Tianyi-Lin/esp32_s3_scd41_co2_detector/3d_models/README.md

# 3D 模型与 FreeCAD 工程

此目录是本地 `ESP32-S3-LCD-1.47B_20260204 (1)` 模型文件夹在 2026-10-28 的快照，保留原有文件名和子目录。未收录 macOS `.DS_Store` 和 FreeCAD 自动备份；原始本地文件没有移动或删除。

## 先选版本，再编辑或打印

这里同时保存了多个设计阶段，**不是一套已经定稿、可以直接全部混用的打印包**。

当前优先查看：[盖板2.5mm_中壳加深_20261028](盖板2.5mm_中壳加深_20261028/)。前后盖基础板厚均为2.5mm，后盖无加深围边，新增深度由中间外壳承担；实际插头和导线空间仍待实物确认。

本版按钮最新突出 **1.5 mm**，侧脚钉高 **2 mm**，横放离桌间隙为 **0.5 mm**。请使用上述版本目录内的新按钮打印文件（打印2件），不要沿用根目录的旧1mm按钮。

四角外壳孔最新沿45°各向外平移 **0.3 mm**，柱体和斜切面随动；外轮廓和R4不变。**三件外壳孔位均已更新，前后盖和中间件必须配套使用，不要混装旧孔位版本。**

后盖中央传感器窗口最新约 **8.422×8.422 mm**，按穿过后盖的实际壳体外形每边留 **0.3 mm**；白色膜仍内缩约1mm。本次收小窗口只需更新后盖，四角孔位保持上述外移0.3mm版本。

| 位置 | 用途与状态 |
| --- | --- |
| `盖板2.5mm_中壳加深_20261028/` | 最新候选版，优先使用其中配套的独立工程、装配、STEP/STL；不要与历史版本混用。 |
| `草图直接编辑工程_修正版/` | 上盖、中间外壳和原下盖的草图/特征工程；优先从这里编辑上盖和中间外壳。 |
| `scripts/` | 本地模型生成、草图重建、历史修补、检查与导出的 Python 源码及 FreeCAD 宏；入口和运行风险见该目录的 README。 |
| `后盖_传感器横置_20261028/` | 传感器未倒装的横置后盖：模块长边平行外壳长边，安装孔距 X=20 mm、Y=18 mm。含独立可编辑后盖、STEP、STL 和装配检查。 |
| `后盖_传感器倒装_内缩1mm_20261028_预览/` | 已被新候选版取代的旧加深后盖方案，仅保留历史记录；不要作为当前方案。 |
| `打印文件/` | 此前导出的打印件与 STEP 快照；不自动包含后面两种后盖方案，使用前需核对版本。按键顶杆文件标注打印 2 件。 |
| `可编辑工程_参数化/`、`草图直接编辑工程/` | 更早阶段的工程及检查记录，作为历史参考；不要与修正版混淆。 |
| 根目录的装配、爆炸图和五色半透明检查工程 | 主要用于检查整机位置和装配关系，不替代各零件的完整草图特征工程。 |
| 根目录的 ESP32、Sensirion STEP/STP、PDF、DWG | 建模时使用的器件参考资料；原始第三方资料的权利与使用条款仍归其提供方。 |

## 旧加深后盖预览的历史说明

- SCD41 本体朝后盖外侧，传感器表面比后盖外表面内缩约 1 mm。
- 保持 ESP32 PCB 下表面到 CO₂ PCB 上表面约 20 mm；为此后盖外轮廓向外加深了 4.28 mm。前盖仍为 3 mm，后盖底板为 2 mm，整机总厚度约 36.53 mm。
- 用户已反馈整机前后显得过厚，需进一步评估布局和减薄方案。
- 模块两侧的接线插座目前仅以简化外形表示，**尚未计入实际插头、拔插操作和导线弯曲空间**。已有实体碰撞检查通过，不代表接线可装配性已验证。

## 如何手工编辑

使用 FreeCAD RC 打开对应零件的 `.FCStd` 文件，展开 `Body`，双击需要修改的 `Sketch` 或特征。各目录里的 `怎么编辑.txt`、`使用说明.txt` 和检查记录提供进一步说明。

- `.FCStd`：FreeCAD 工程；带草图/特征历史的独立零件适合手工改尺寸、孔位和特征。
- `.step` / `.stp`：交换实体几何，不能保留原始 FreeCAD 草图特征历史。
- `.stl`：打印用三角网格，不适合按原特征直接编辑。

模型相关 Python 源码和 FreeCAD 宏现已同步到 `scripts/`，保留本地源码内容，未因上传重新生成或修改模型几何。尺寸单位均为 mm，打印前请结合实际电路板、插头和紧固件再次核对。
