Tianyi-Lin/esp32_s3_scd41_co2_detector/3d_models/scripts/README.md

# 模型生成与检查源码

这里归档了本地建模工作区中与 ESP32-S3 / SCD41 外壳相关的 Python 脚本及 FreeCAD 宏。生成脚本、辅助模块、历史修补和检查脚本保留原文件名和代码；无关的毕业实验绘图、网络测试绘图脚本没有收录。

## 主要入口

| 文件 | 用途 |
| --- | --- |
| `redesign_uniform_covers.py` | 当前候选版入口：前后平板均2.5mm、后盖无外围围边，中间壳承担新增高度，维持1mm内缩与20mm板间距；导出独立工程、装配及经过验证的STEP/STL。 |
| `style_uniform_assembly.py` | 给当前候选版的无 GUI 信息装配添加外观：三件外壳50%半透明、电子器件不透明；校验原文档和几何数据逐字节不变。标准 Python 3 可运行。 |
| `fix_co2_connector_layout.py` | 将当前 CO₂ PCB 的两个简化插座改到长边方向左右两端；不旋转 PCB、不改变孔位和打印件；保留原装配显示外观并检查碰撞，输出到独立暂存目录。 |
| `apply_button_projection15.py` | 当前按钮突出1.5mm、脚钉2mm修正；保留内侧接触和限位，重导出中间件工程/STEP/STL和按钮STEP/STL（打印2件），验证0.5mm离桌间隙和0.8mm导向行程。 |
| `shift_corner_mounts.py` | 四角孔沿45°各外移0.3mm，三件孔位/沉孔及中间件柱体和八段斜切面同步；外形45.4×33.9/R4不变，保留按钮、脚钉和电子件，导出配套工程与STEP/STL。 |
| `resize_sensor_window.py` | 后盖中央窗口按真实SCD41在后盖内表面处的壳体截面每边+0.3mm，约8.422×8.422/R1.704；不按10.1mm远端凸缘放大，保持可编辑草图及1mm内缩，并检查实体间隙和STEP/STL。 |
| `design_inverted_scd41_cover.py` | 最新倒装后盖预览：传感器朝外、表面内缩约 1 mm，导出独立后盖及倒装装配。方案尚未定稿。 |
| `redesign_bottom_sensor_landscape.py` | 未倒装的横置后盖：长边平行外壳长边，安装孔距 X20 / Y18。 |
| `create_compact_stacked_enclosure.py` | 紧凑双层外壳的整机生成入口，调用本目录多个几何辅助模块。 |
| `rebuild_editable_enclosure.py` | 将实体重建成参数化零件。 |
| `rebuild_direct_sketch_enclosure.py` | 生成带草图和特征历史的独立编辑工程；依赖上一个模块。 |
| `repair_sketch_engineering.py`、`repair_top_native_fillet.py` | 草图孔位联动修正及上盖圆角修复。 |
| `create_exploded_inspection.py` | 爆炸检查工程。 |
| `create_five_color_inspection.FCMacro` | 五色半透明装配检查宏，需要 FreeCAD 图形界面。 |
| `export_checked_enclosure_steps.py`、`audit_print_mesh_orientation.py` | STEP 导出和打印网格检查。 |

其余 `apply_*`、`resize_*`、`update_*` 等包含历史阶段的几何修改；`inspect_*`、`audit_*`、`test_*`、`probe_*` 等记录检查或试验。文件名前缀不保证只读，应先看代码中的保存、导出语句。

## 运行前必读

1. 这些是**原始工作源码快照**，不是一个可直接“一键顺序运行所有文件”的发布工具包。上传时只验证了语法和源码同步，没有重新执行建模，也没有重新验证所有历史脚本。
2. 许多脚本保留原机器的绝对路径，包括模型目录、`sys.path` 和 `.cad-recovery` 输出目录。在其他位置运行前，必须核对并修改对应路径；不要只修改一个入口却忽略其导入模块。
   当前 `redesign_uniform_covers.py` 及其两个草图生成直接依赖已支持同目录导入、仓库相对路径；入口可传 `--root` 指定模型目录，输出到该目录下独立的 `.cad-recovery` 暂存文件夹。此改进不代表其他历史脚本已全部迁移。
3. 部分脚本在导入或执行时会创建工程、修改已有文件或保存导出。**先复制模型到独立测试目录，再运行**；不要直接针对唯一的模型原件执行，也不要把历史修补脚本重复应用到最新零件。
4. 几何脚本依赖 FreeCAD 自带 Python 模块，如 `FreeCAD`、`Part`、`Sketcher`、`Mesh`、`MeshPart`；普通系统 Python 通常不能直接运行。带 `FreeCADGui` 的脚本需要图形界面。部分检查还依赖 NumPy 等模块。
5. 本次建模使用 FreeCAD 26.3.0 RC2。主生成脚本不代表所有历史脚本都经过此版本的独立回归测试。
6. 最新倒装预览依赖横置装配以及草图重建辅助模块；生成后仍需解决整机厚度和实际接线插头空间问题，不能据此直接认定可打印装配。

脚本与已保存模型共同归档，但并非每个历史脚本都对应当前发布的几何状态。已有 `.FCStd` 才是本次同步的模型快照；手工改尺寸时可直接使用带草图特征的工程。
