Tianyi-Lin/esp32_s3_scd41_co2_detector/3d_models/盖板2.5mm_中壳加深_20261028/README.md

# 当前候选版：前后盖 2.5 mm，新增深度由中间外壳承担

这是 2026-10-28 按最新要求修改的独立版本，原来的横置后盖和加深后盖预览均保留，不覆盖历史工程。

## 本次修改

- 前盖基础板厚 **2.5 mm**，后盖基础板厚 **2.5 mm**。
- **后盖没有外围加深围边**，外底面 Z=0，内侧大平面 Z=2.5；内部四个传感器安装支撑台保留。这些局部支撑台不属于板厚或外围围边。
- SCD41 保持长边平行外壳长边，安装孔距 X20 / Y18；传感器倒装朝外，表面低于后盖外表面约 **1 mm**。
- 后盖中央传感器窗口已从 10.7×10.7 mm 收小到约 **8.422×8.422 mm、R1.704**。依据真实 STEP 在后盖内表面 **Z=2.5 mm** 处约 7.822×7.822 mm 的壳体外形，每边留 **0.3 mm**；不再把远离后盖的 10.1 mm PCB 侧凸缘作为窗口尺寸。稍椭圆的角部用可编辑圆弧草图拟合，截面间隙偏差在 0.002 mm 内。
- CO₂ PCB 安装面 Z=7.28，PCB 上表面 Z=8.48；ESP32 PCB 下表面 Z=28.48，两块 PCB 的垂直距离保持 **20 mm**。
- 新增高度由中间外壳承担；中层板、ESP32、Type-C 窗口和按钮同步上移 **4.28 mm**。侧脚钉、双层四角螺丝柱的 45°平面切削等结构保留。
- 两侧按钮由突出 1 mm 改为 **1.5 mm**；R1.5 半球端头的赤道与壳面齐平，内侧接触面、限位环及 0.8 mm 导向行程保持不变。经确认，四个一体脚钉由 1.5 mm 加高至 **2 mm**，横放时按钮离桌面仍为 **0.5 mm**，脚端 R0.35 圆角不变。
- 相比横置、未倒装版本，中间件下配合面从 Z2.05 改为 Z2.55，上配合面上移 4.28 mm，所以中间件零件高度净增加 **3.78 mm**，变为约 **30.98 mm**。
- 前后盖四角通孔同轴，M2.5 沉孔直径仍为 **5.1 mm**。前盖沉孔深 1.35，后盖沉孔深 1.4。
- 四角外壳固定孔现各沿 **45° 向外平移 0.3 mm**，即 X/Y 各移约 0.212132 mm；孔轴心为 **X=±19.072132、Y=±13.032132 mm**。中间件的螺丝柱及上下两层共八段 45° 切削面同步平移，切面距孔轴心仍为 2.781853 mm，按 M2.5 公称直径计算切面侧最薄壁仍约 1.531853 mm。
  三件外轮廓 **45.4×33.9、R4** 不变，Ø5.1 沉孔到外缘最薄约 **1.068912 mm**。ESP32/CO₂ 自身固定孔、屏幕、接线插座、按钮和脚钉位置不变。
- 减薄后重建了显示窗的上口过渡：下口仍为 **32.85×17.89、R2.5、中心 X=-1.5675**；上口改为同心等宽外扩的 **35.946×20.986、R4.048**，保留 R0.4 上缘过渡。没有改变显示区域的下口位置。此调整消除了旧偏心斜面在 STEP 转换和网格化时的问题。

整机前后外表面距离约 **36.03 mm**。本次主要统一盖板并转移加深结构，不代表已压缩 20 mm 接线空间。

## 文件

- `装配检查_盖板2.5mm_中间壳加深.FCStd`：完整紧凑装配，包含两块电路板、SCD41 本体及两个简化插座。
  前盖（蓝）、后盖（紫）、中间壳（橙）均为 **50% 半透明**；ESP32（绿）和 CO₂ 模块（红）保持不透明。此项仅为显示外观，尺寸、装配位置、独立零件工程和打印文件未改变。
  CO₂ PCB 的两个接线插座已从上下边修正到**左右两端（沿 PCB 长边 X）**，不是旋转整块电路板；PCB、固定孔、传感器本体及打印件均保持原位。插座仍是沿用原尺寸的简化占位体，插头和导线未建模。
- `上盖_2.5mm_草图编辑.FCStd`、`后盖_2.5mm_无围边_草图编辑.FCStd`、`中间外壳_加深_草图编辑.FCStd`：独立草图/特征工程。
- `打印文件/`：对应本版的三件外壳及按钮的 STL、STEP。按钮文件为 `按键顶杆_突出1.5mm_打印2件`，同一模型打印 **2 件**，已按限位环平底朝下、半球朝上放置。不要混用旧目录中的 1 mm 按钮、后盖或中间件。
- `检查记录.json`：实体、STEP 读回、STL、孔位同轴及装配碰撞检查结果。
- 生成源码：`../scripts/redesign_uniform_covers.py`。在 FreeCAD Python 环境执行，默认使用所在仓库的模型目录，也支持 `--root`；输出到独立暂存目录，不覆盖输入工程。
- 半透明外观保存工具：`../scripts/style_uniform_assembly.py`。用于给没有 GUI 显示信息的新生成装配添加上述外观；已有显示信息时会拒绝覆盖。
- 接线插座布局修正：`../scripts/fix_co2_connector_layout.py`，检查记录为 `接线插座布局检查.json`；主生成入口也会应用此修正。
- 按钮与脚钉修正：`../scripts/apply_button_projection15.py`，记录为 `按钮1.5mm_脚钉2mm检查.json`。独立中间件工程的 `FootPad.Length` 现为 2 mm；装配、打印中间件与按钮导出均已同步。
- 四角孔位修正：`../scripts/shift_corner_mounts.py`，记录为 `四角孔外移0.3mm检查.json`。**前盖、后盖、中间件的孔位都变了，必须使用本目录最新的配套三件，不能与外移前版本混装。** 各单项检查记录保留变更当时的状态，最新汇总以 `检查记录.json` 为准。
- 传感器窗口修正：`../scripts/resize_sensor_window.py`，记录为 `传感器窗口每边0.3mm检查.json`。这次仅更新后盖及装配中的后盖，不改变四角孔位；此前已按四角外移0.3mm版本打印的前盖、中间件和按钮可以继续使用。

## 检查边界

三件外壳均为单一有效实体，独立工程保存后可重开、草图完全约束；STEP 读回通过扩展几何检查。外壳和按钮 STL 均封闭、单连通，无非流形、无自交、无不一致三角面朝向。两侧按钮镜像后为相同打印件，内侧接触面未改变，0.3/0.5/0.8 mm 按压位移检查无外壳碰撞。现有装配模型检查的部件之间无体积重叠。

**实际插头、拔插操作和导线弯曲空间仍未验证。** 两个插座仍是简化外形，现有模型无碰撞不等于实物接线已确认。本版是用于继续检查的候选版，打印前仍需结合插上线的传感器实物核对。
