Tianyi-Lin/esp32_s3_scd41_co2_detector/3d_models/可编辑工程_参数化/使用说明.txt

三个独立的 FreeCAD 参数化工程
============================

打开方式
使用 FreeCAD 26.3 RC2 打开：
  上盖_参数化.FCStd
  下盖_参数化.FCStd
  中间外壳_参数化.FCStd

这不是 STEP 改后缀，也不是在导入实体上附加空草图。
三件均由原生草图、尺寸约束、拉伸、凹槽、放样和圆角特征重建。
文件不依赖生成脚本、自定义 Python 模块或外部模型链接。

怎样修改尺寸
1. 展开左侧文件名称，双击“尺寸参数（双击，修改 B 列）”。
2. A 列是参数名称，B 列是尺寸，C 列是说明。
3. 修改 B 列黄色单元格，例如孔径改为“2.3 mm”，按回车。
4. 灰色单元格是公式计算值，通常不直接改。
5. 如未刷新，选择“编辑 → 重新计算”（Command+R）。
6. 保存前查看模型是否出现红色错误标记，并检查孔位、壁厚及装配。

负数位置请输入公式格式，例如“=-16.814 mm”。
不要把尺寸写成纯文字或删除单位。

怎样修改草图、建模特征
展开“可编辑实体”中的特征即可找到对应草图。
双击草图可以进入编辑；尺寸约束已与尺寸表连接，日常改尺寸优先改表。
如要将某个草图尺寸改为独立数值，需要先移除该尺寸原来的表达式引用。
也可以继续在 Body 内增加新的草图、拉伸、凹槽等特征。
保持最终特征可见，不要同时显示全部历史特征。

各文件内容
上盖：外轮廓、厚度、显示窗上下截面、斜面、外口圆角、四角通孔、沉孔。
下盖：外轮廓、厚度、CO2 凸台、18×20 mm 孔距、通孔、沉孔、37 个透气孔。
中间外壳：侧壁、中层板、四角柱、ESP32 凸台与通孔、排针槽、中央开口、
45 度切削、Type-C 开口、按钮导向与滑动孔、两侧通风槽、四个脚钉及圆角。

独立文件之间的关系
三件保留了原装配坐标，不是把所有零件都移动到底面 Z=0。
三件没有相互的外部链接。改共同外轮廓、四角孔距或接合高度时，
需要同步修改其他相关文件，并重新检查装配。
这些文件不会自动改动旧装配图、STEP 或 STL。
修改后要打印，应选择 Body 的最终实体重新导出，不要误用旧打印文件。

验证与限制
下盖、中间外壳与现版原模型的实体差集均为零，外形一致。
上盖的孔、圆柱面与外包络一致；显示窗曲面双向采样对比的最大偏差
约 0.00072 mm，体积差约 0.0064 mm³，属于本次圆角重建的微小数值差。
上盖保留了原模型圆角曲面的 GeomAbs_C0 连续性诊断信息；
普通实体有效性检查通过，不将扩展检查描述为“全部无警告”。
上盖以线性偏差 0.001 mm、角度偏差 0.03 rad 试算网格：303718 个三角面，
单一封闭网格，无非流形边、无反向三角面、无自交；未覆盖原 STL。
30 张草图均完全约束。测试过尺寸、孔径、孔位、槽距、切削偏距等修改，
均能重新计算，测试后已恢复原值，三个文件均已保存并重新打开验证。
这些检查不代表任意大幅改动都不会失败，也不是打印强度或螺纹可靠性认证。
原装配工程及已有打印文件未覆盖。
