Tianyi-Lin/esp32_s3_scd41_co2_detector/3d_models/后盖_传感器倒装_内缩1mm_20261028_预览/设计说明.txt

SCD41 倒装、白色表面内缩 1 mm — 独立预览版

本版按现有真实 SCD41 本体 STEP 和 20×18 mm 安装孔距设计。
传感器保持横放，25.4 mm 长边平行外壳长边；PCB 翻面，传感器朝后盖外侧。
后盖中央开贯穿窗口，让传感器上表面直接面向外部空气。
白色表面比后盖外表面向内退让约 1 mm，壳体不顶压白色表面。

重要外形变化：
现有传感器本体从 PCB 元件面到白色表面高 6.28 mm。
为保持之前 ESP32 PCB 下表面至 CO2 PCB 上表面的 20 mm 空间，
本版让后盖向外加深 4.28 mm，采用浅盒形状，未移动中间壳、ESP32 或上盖。
新后盖与中间壳的配合平面、外侧四孔位置、45.4×33.9 mm 外轮廓保持。
整机厚度相应增加 4.28 mm；请先看装配预览，确认外凸量再用于下单。

主要尺寸：
后盖底板厚 2 mm，新增围边壁厚 2.2 mm。
传感器窗口 10.7×10.7 mm、R0.7，名义上相对本体10.1mm包络每侧让位0.3mm。
传感器支撑台从新底板内侧起高 5.28 mm、外径5 mm，顶面仍在原安装高度。
四个安装孔中心距沿外壳长边20 mm、沿短边18 mm；通孔Ø2.8 mm。
八个外侧平底沉孔均为Ø5.1 mm、深1.4 mm。
原中央通气孔区域改成传感器窗口，窗口外围保留12个Ø1.5 mm圆孔。

文件：
装配检查_传感器倒装_薄膜内缩1mm.FCStd：完整装配的独立预览。
后盖_传感器倒装_薄膜内缩1mm_预览.FCStd：带草图/特征历史的可编辑后盖。
后盖_传感器倒装_薄膜内缩1mm_预览.step：用于检查几何或给打印方。
后盖_传感器倒装_薄膜内缩1mm_预览.stl：仅后盖的打印网格。
检查记录.json：本轮尺寸、碰撞和网格检查结果。

查看建议：
打开完整装配后，切换到底视图看外侧窗口与白色表面。
打开后盖 STEP，可单独看中央窗口、四个长支撑台和新增围边。
FreeCAD RC 此前有过打开/切换 FCStd 时退出的情况，查看几何时可先用 STEP。

手工编辑：
可编辑工程中的“倒装保护尺寸”保存薄膜退让量、传感器高度和安装基准。
默认 MembraneRecess=1 mm；修改后后盖底板、围边和支撑高度会联动。
修改“CO2 横置孔位草图（主控：20×18）”，对应通孔和沉孔保持同轴。
外侧四孔有独立主控草图；其他独立零件文件不会跨文件自动同步。

检查结果：
原生后盖、重新读入的 STEP 均为单一有效实体，扩展几何检查通过。
保存后重新打开的草图均为完全约束状态，装配中的退让尺寸检查通过。
STL 重新读入后为单壳体、封闭、无非流形边、无自交且面方向一致。
倒装的 PCB、SCD41 本体和插座逐件检查，与后盖、侧壁、中层、ESP32、
排针预留体及上盖的实体重叠均为零。
ESP32 PCB 下表面至 CO2 PCB 上表面仍为20 mm。

装配前需与实物核对：
本模型未包含实际线缆与插头的全部形状；请核对实物PCB元件面及接线空间。
1 mm 退让用于减少表面擦碰，窗口没有增加护网，不能完全隔绝手指或尖物。
加深后需要重新核对螺丝长度；若保持与原来相同的螺纹啮合长度，
穿过后盖的螺杆应相应增加约4.28 mm。

旧装配、上一版横置后盖和原“打印文件”均未覆盖。
