Tianyi-Lin/esp32_s3_scd41_co2_detector/3d_models/后盖_传感器横置_20261028/使用说明.txt

2026-10-28 后盖：SCD41 传感器横置修正版

核对结果：旧模型的传感器 PCB 长边沿外壳短边，方向相差 90°。
本版将传感器长边改为平行外壳长边，并同步调整后盖四个支撑台、
四个通孔及对应沉孔。孔距沿外壳长边 20 mm，沿短边 18 mm，均为中心距。
孔中心坐标：X=±10 mm，Y=±9 mm。

打印：后盖_传感器横置_20x18mm.stl
也可向打印方提供：后盖_传感器横置_20x18mm.step
可编辑工程：后盖_传感器横置_20x18mm.FCStd，使用 FreeCAD RC 打开。
装配核对：装配检查_传感器横置.FCStd，已把传感器和后盖一起改为横置。
装配文件用于检查；只需打印后盖，不要把传感器或整套装配一起打印。

后盖外形仍为 45.4×33.9 mm，基板厚 2 mm，支撑台高 1 mm。
外侧四个外壳固定孔的位置保持不变，可继续使用现有中间壳和上盖。
传感器安装支撑台外径 5 mm，通孔直径 2.8 mm；外侧平底沉孔
直径 5.1 mm、深 1.4 mm，保持之前尺寸。
原来的 37 个底部通气孔保持不变，距新沉孔的最小净距为 1.7 mm。

当前装配模型中的传感器 PCB 外形为 25.4×22.86 mm，安装高度不变。
横置后与侧壁最小间隙约 3.32 mm，与 ESP32、排针预留体无实体重叠。
模型孔位依据此前确认的长边 20 mm、短边 18 mm；打印前可再与实物
四个孔的中心距核对。

可编辑工程中，修改“CO2 横置安装孔位草图（主控：长边20、短边18）”
的 HoleN_X / HoleN_Y，对应通孔和沉孔会自动跟随；孔径单独控制。
此文件与旧装配和其他独立工程没有跨文件自动同步。

已检查原生实体与重新读入的 STEP：单一有效实体，扩展几何检查通过。
STL 已重新读入检查：封闭、单壳体、无非流形边、无自交，面方向一致。
保存后重新打开的孔位检查通过，详细结果见“检查记录.json”。
旧版装配、工程及“打印文件”文件夹均未覆盖。需要新后盖时使用本文件夹。
