Tianyi-Lin/esp32_s3_scd41_co2_detector/3d_models/ESP32-S3-LCD-1.47B_紧凑装配_五色半透明检查.FCStd

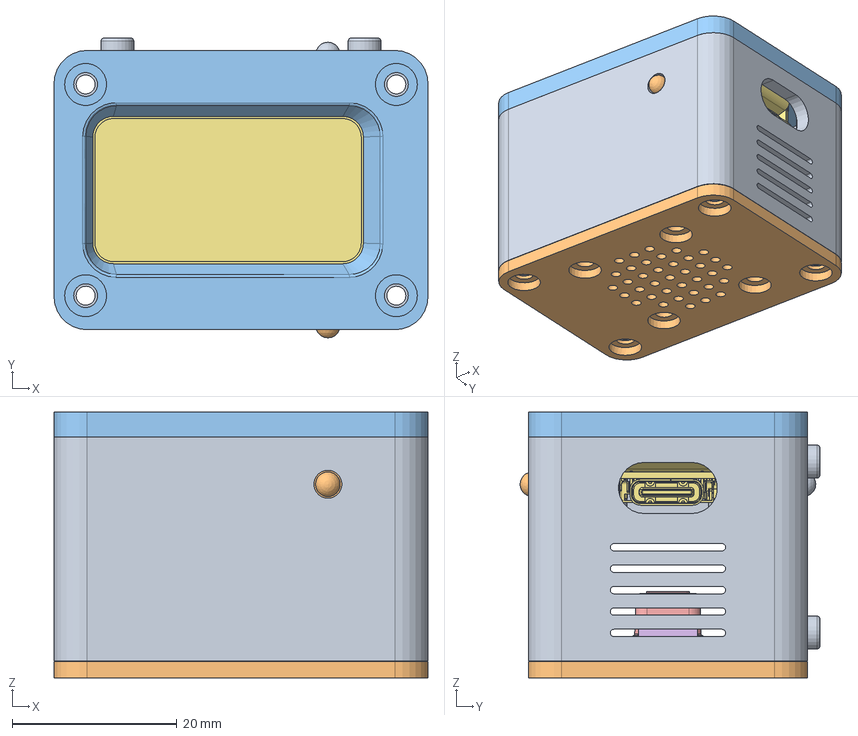
[picture p1: CAD file, 2026-10-28]
3d_models/ESP32-S3-LCD-1.47B_紧凑装配_五色半透明检查.FCStd
45.4 x 36.4 x 32.3 mm
03 中间外壳｜橙色
02 下盖｜紫色
前盖（内侧同平面，无微小环形台阶）
05 CO2 模块 PCB｜红色
CO2 SCD41 传感器本体｜红色
CO2 模块插座｜红色
04 ESP32 总成｜绿色
ESP32 排针参考｜绿色
中间外壳附属按钮 1｜橙色
中间外壳附属按钮 2｜橙色
