Tianyi-Lin/esp32_s3_scd41_co2_detector/3d_models/可编辑工程_参数化/下盖_参数化.FCStd

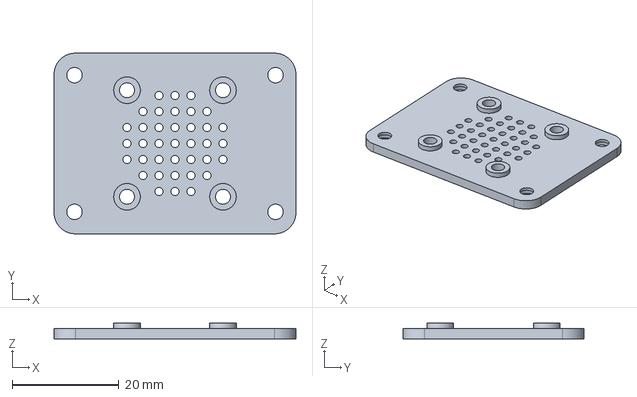
[picture p2: CAD file, 2026-10-28]
3d_models/可编辑工程_参数化/下盖_参数化.FCStd
45.4 x 33.9 x 3.00 mm
