Tianyi-Lin/esp32_s3_scd41_co2_detector/3d_models/后盖_传感器倒装_内缩1mm_20261028_预览/后盖_传感器倒装_薄膜内缩1mm_预览.step

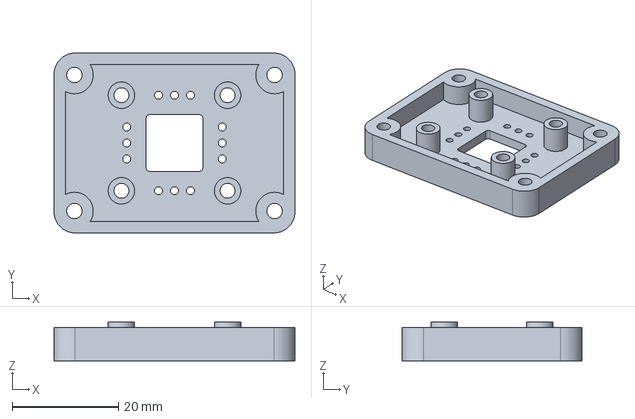
[picture p3: CAD file, 2026-10-28]
3d_models/后盖_传感器倒装_内缩1mm_20261028_预览/后盖_传感器倒装_薄膜内缩1mm_预览.step
45.4 x 33.9 x 7.28 mm
