Tianyi-Lin/esp32_s3_scd41_co2_detector/3d_models/打印文件/ESP32-S3-LCD-1.47B_紧凑双层外壳_后壳.stl

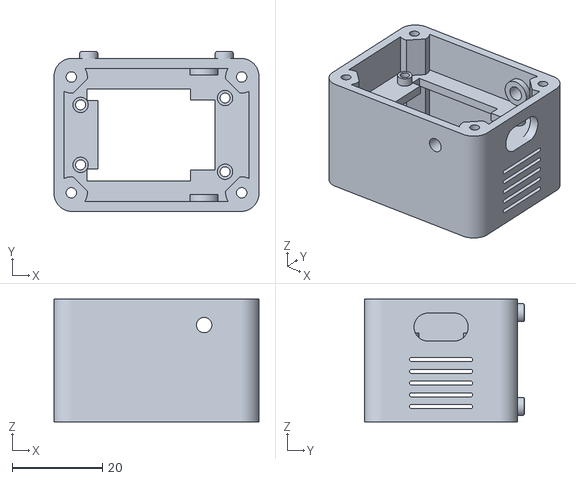
[picture p4: CAD file, 2026-10-28]
3d_models/打印文件/ESP32-S3-LCD-1.47B_紧凑双层外壳_后壳.stl
45.4 x 35.4 x 27.2
