Tianyi-Lin/esp32_s3_scd41_co2_detector/3d_models/打印文件/STEP/ESP32-S3-LCD-1.47B_上盖.step

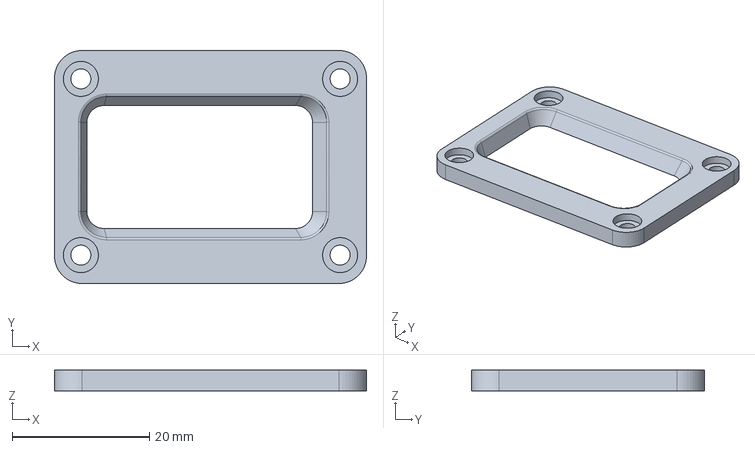
[picture p5: CAD file, 2026-10-28]
3d_models/打印文件/STEP/ESP32-S3-LCD-1.47B_上盖.step
45.4 x 33.9 x 3.00 mm
