Tianyi-Lin/esp32_s3_scd41_co2_detector/3d_models/盖板2.5mm_中壳加深_20261028/打印文件/后盖_2.5mm_无围边_草图编辑.step

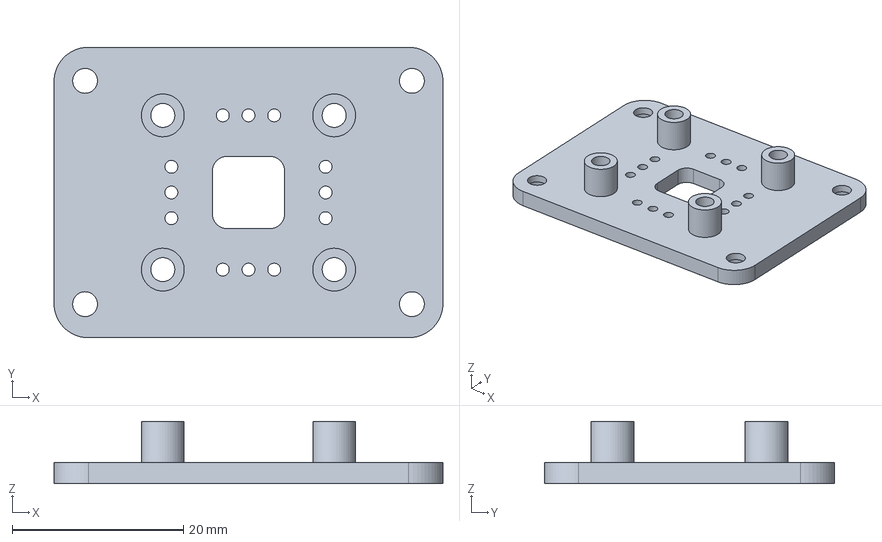
[picture p6: CAD file, 2026-10-28]
3d_models/盖板2.5mm_中壳加深_20261028/打印文件/后盖_2.5mm_无围边_草图编辑.step
45.4 x 33.9 x 7.28 mm
