Tianyi-Lin/esp32_s3_scd41_co2_detector/3d_models/盖板2.5mm_中壳加深_20261028/装配检查_盖板2.5mm_中间壳加深.FCStd

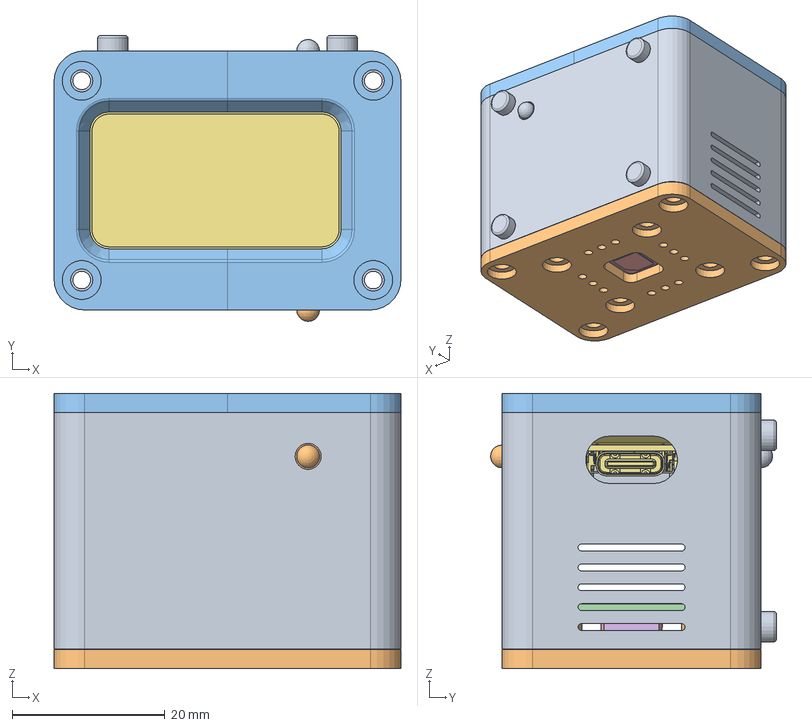
[picture p7: CAD file, 2026-10-28]
3d_models/盖板2.5mm_中壳加深_20261028/装配检查_盖板2.5mm_中间壳加深.FCStd
45.4 x 37.4 x 36.0 mm
中间外壳（承担新增高度）
后盖 平板2.5mm（无加深围边）
前盖 平板2.5mm
CO2 横置PCB（倒装安装面Z7.28）
SCD41 朝外（表面内缩1mm）
SCD41 左右接线插座（简化外形，沿长边X）
ESP32 总成（旋转 90°，前层）
焊接排针穿透预留（2×9，间距 2.54）
内装式单圆台推杆（BOOT/RST，打印件 1）
内装式单圆台推杆（BOOT/RST，翻转件 2）
