Tianyi-Lin/esp32_s3_scd41_co2_detector/3d_models/Sensirion_CO2_Sensors_SEK-SCD41_STEP_file.STEP

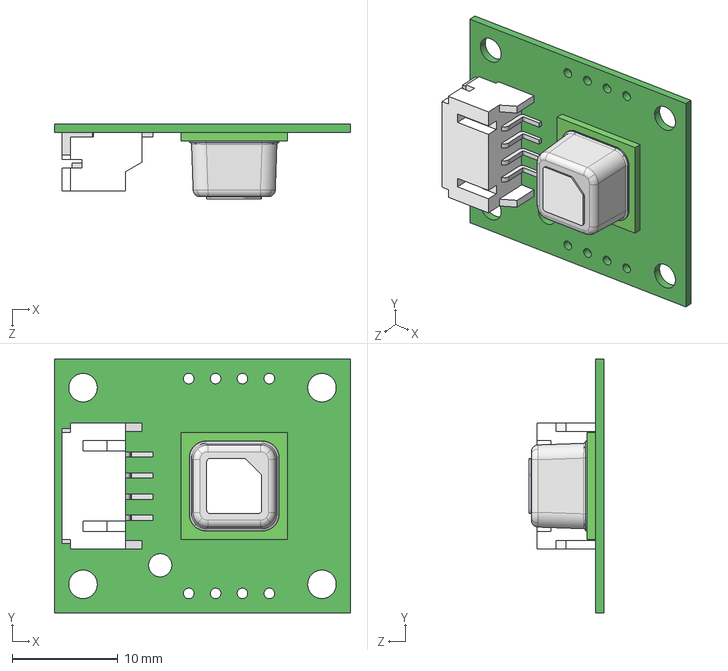
[picture p8: CAD file, 2026-10-28]
3d_models/Sensirion_CO2_Sensors_SEK-SCD41_STEP_file.STEP
28.0 x 24.0 x 7.11 mm
