Tianyi-Lin/esp32_s3_scd41_co2_detector/3d_models/后盖_传感器倒装_内缩1mm_20261028_预览/装配检查_传感器倒装_薄膜内缩1mm.FCStd

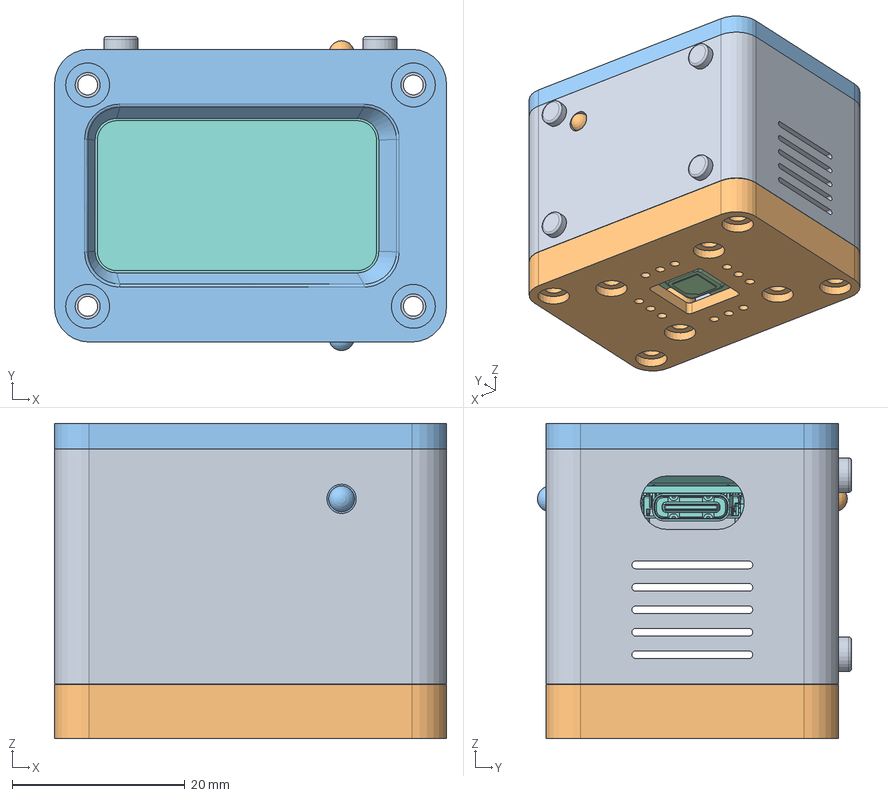
[picture p9: CAD file, 2026-10-28]
3d_models/后盖_传感器倒装_内缩1mm_20261028_预览/装配检查_传感器倒装_薄膜内缩1mm.FCStd
45.4 x 36.4 x 36.5 mm
侧壁＋中间层（上下盖 M2.5 攻丝柱）
倒装保护后盖（向外加深4.28mm，薄膜内缩1mm）
前盖（内侧同平面，无微小环形台阶）
SCD41 横置倒装总成（PCB高度保持）
SCD41 黑色 PCB（背面朝下）
SCD41 倒装朝外（薄膜低于后盖1mm）
SCD41 上下 STEMMA QT 插座
ESP32 总成（旋转 90°，前层）
焊接排针穿透预留（2×9，间距 2.54）
内装式单圆台推杆（BOOT/RST，打印件 1）
内装式单圆台推杆（BOOT/RST，翻转件 2）
