Tianyi-Lin/esp32_s3_scd41_co2_detector/3d_models/后盖_传感器横置_20261028/装配检查_传感器横置.FCStd

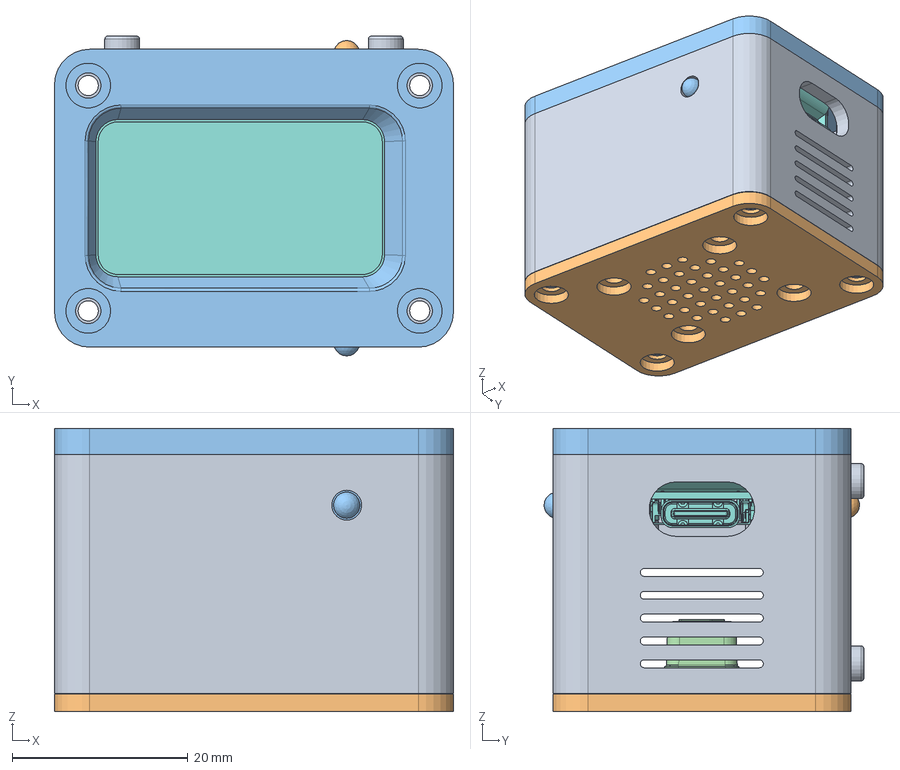
[picture p10: CAD file, 2026-10-28]
3d_models/后盖_传感器横置_20261028/装配检查_传感器横置.FCStd
45.4 x 36.4 x 32.3 mm
侧壁＋中间层（上下盖 M2.5 攻丝柱）
后盖：传感器横置，孔距长边20 mm/短边18 mm
前盖（内侧同平面，无微小环形台阶）
SCD41 横置总成（长边平行外壳长边）
SCD41 黑色 PCB（背面朝下）
SCD41 传感器本体（真实 STEP，朝上）
SCD41 上下 STEMMA QT 插座
ESP32 总成（旋转 90°，前层）
焊接排针穿透预留（2×9，间距 2.54）
内装式单圆台推杆（BOOT/RST，打印件 1）
内装式单圆台推杆（BOOT/RST，翻转件 2）
