Tianyi-Lin/esp32_s3_scd41_co2_detector/3d_models/ESP32-S3-LCD-1.47B.stp

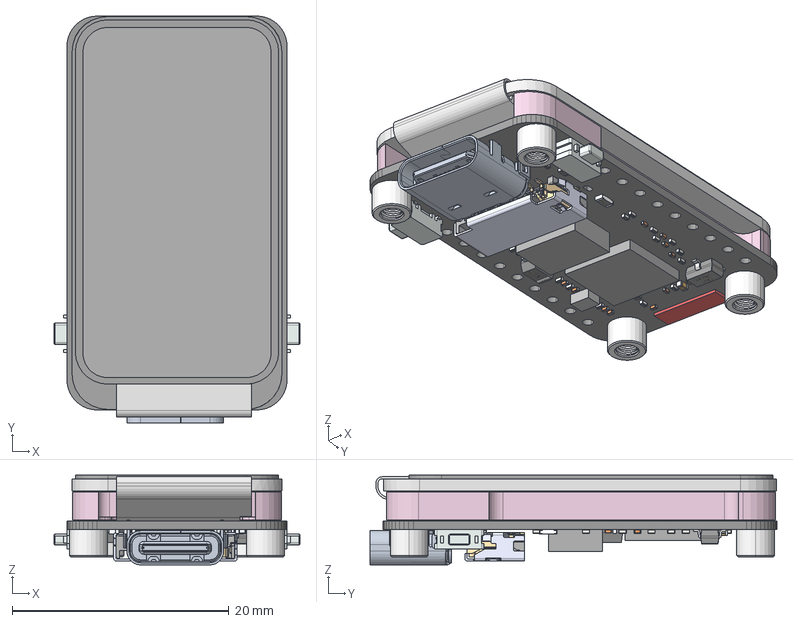
[picture p12: CAD file, 2026-10-28]
3d_models/ESP32-S3-LCD-1.47B.stp
22.7 x 37.6 x 8.30 mm
1_47INCH-172X320-LCD
BOARD
_2_1_2_3_4_AF0 x 2
_7_1_2_AF0 x 2
USER_LIBRARY-0201_0603M__CAP_1 x 20
USER_LIBRARY-0201_0603M__CAP_2 x 20
USER_LIBRARY-0201_0603M__CAP_3 x 20
EXTRUDED-66940
SOT23-5AND6_00 x 5
SOT23-5-14065_AF0
EXTRUDED-124313
EXTRUDED-124708
USER_LIBRARY-RES_0603-0201_1 x 31
USER_LIBRARY-RES_0603-0201_2 x 31
USER_LIBRARY-RES_0603-0201_3 x 31
USER_LIBRARY-RES_0603-0201_4 x 31
5_1_2_A
_7_AF0
SOT-23 x 2
EXTRUDED-184200
EXTRUDED-184623
EXTRUDED-185018
3_1_A x 4
3_1_2_A
SOD123F
PRT0001
ESP32-S3-LCD-1_47B-PMMA
SWITCH-TS24CA x 2
SMTSO-M2-2_5ET x 4
TF-CARD-BASE
