Tianyi-Lin/esp32_s3_scd41_co2_detector/3d_models/盖板2.5mm_中壳加深_20261028/上盖_2.5mm_草图编辑.FCStd

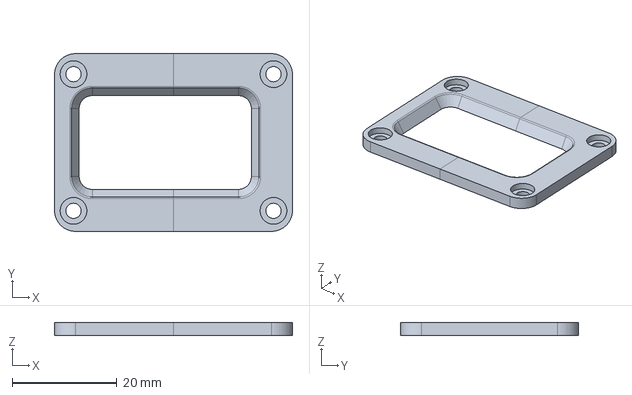
[picture p13: CAD file, 2026-10-28]
3d_models/盖板2.5mm_中壳加深_20261028/上盖_2.5mm_草图编辑.FCStd
45.4 x 33.9 x 2.50 mm
