Tianyi-Lin/esp32_s3_scd41_co2_detector/3d_models/ESP32-S3-LCD-1.47B_装配检查_爆炸图.FCStd

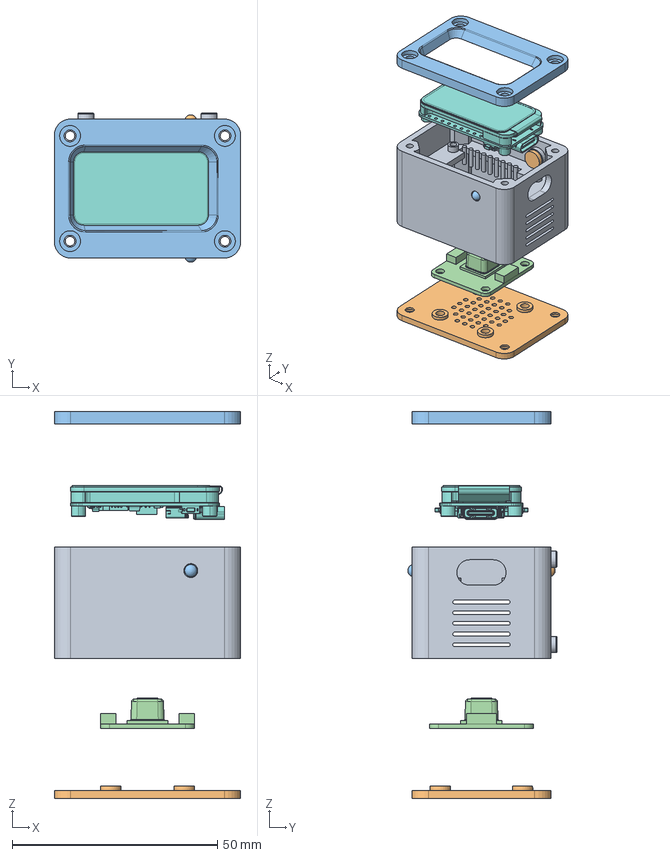
[picture p14: CAD file, 2026-10-28]
3d_models/ESP32-S3-LCD-1.47B_装配检查_爆炸图.FCStd
45.4 x 36.4 x 94.3 mm
侧壁＋中间层（上下盖 M2.5 攻丝柱）
可拆下盖（M2.5 螺丝固定到侧壁）
前盖（内侧同平面，无微小环形台阶）
SCD41 总成碰撞参考（含真实 STEP 本体）
SCD41 黑色 PCB（背面朝下）
SCD41 传感器本体（真实 STEP，朝上）
SCD41 上下 STEMMA QT 插座
ESP32 总成（旋转 90°，前层）
焊接排针穿透预留（2×9，间距 2.54）
内装式单圆台推杆（BOOT/RST，打印件 1）
内装式单圆台推杆（BOOT/RST，翻转件 2）
