Tianyi-Lin/esp32_s3_scd41_co2_detector/3d_models/盖板2.5mm_中壳加深_20261028/打印文件/按键顶杆_突出1.5mm_打印2件.step

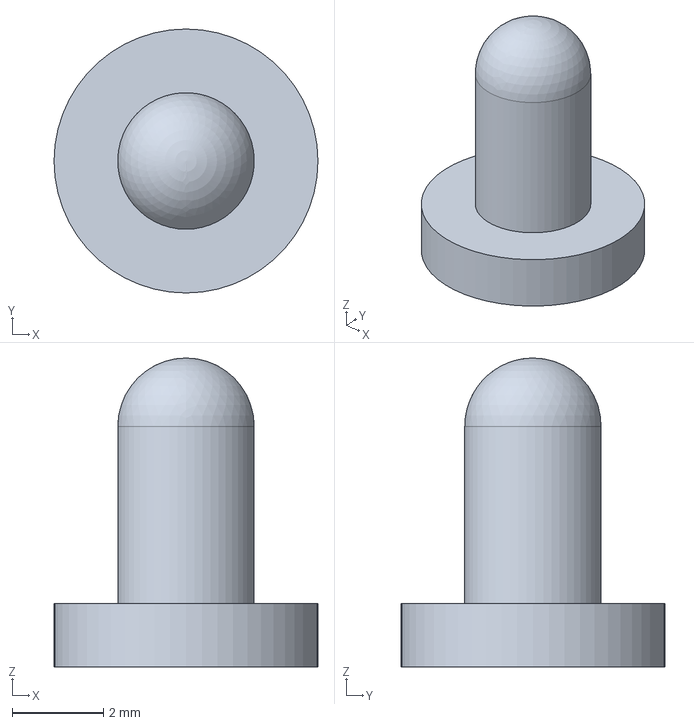
[picture p15: CAD file, 2026-10-28]
3d_models/盖板2.5mm_中壳加深_20261028/打印文件/按键顶杆_突出1.5mm_打印2件.step
5.80 x 5.80 x 6.79 mm
