Tianyi-Lin/esp32_s3_scd41_co2_detector/3d_models/ESP32-S3-LCD-1.47B_紧凑双层外壳_按键顶杆_打印2件.stl

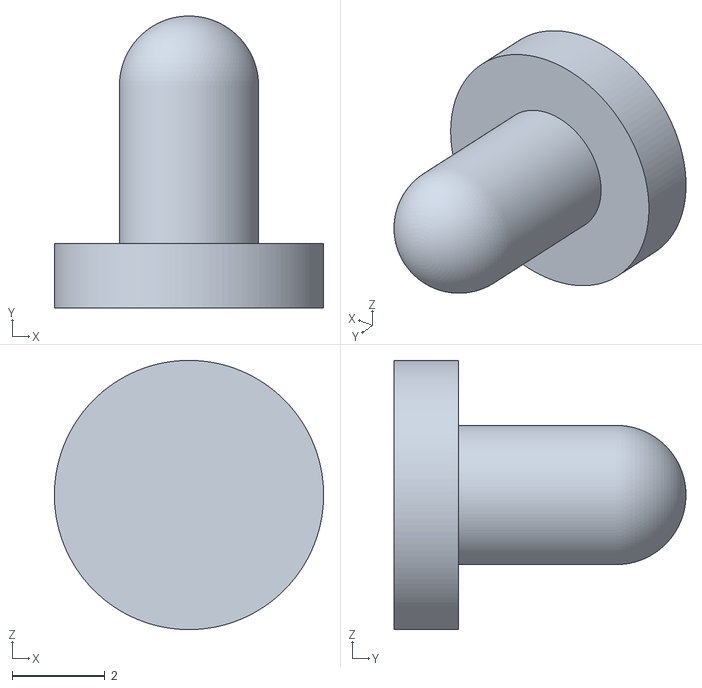
[picture p16: CAD file, 2026-10-28]
3d_models/ESP32-S3-LCD-1.47B_紧凑双层外壳_按键顶杆_打印2件.stl
5.80 x 6.29 x 5.80
