Tianyi-Lin/esp32_s3_scd41_co2_detector/(list of files, cad)

Other CAD files:
3d_models/后盖_传感器横置_20261028/后盖_传感器横置_20x18mm.step
3d_models/草图直接编辑工程/上盖_草图编辑.FCStd
3d_models/草图直接编辑工程_修正版/上盖_草图编辑.FCStd
3d_models/可编辑工程_参数化/中间外壳_参数化.FCStd
3d_models/打印文件/ESP32-S3-LCD-1.47B_紧凑双层外壳_可拆底盖.stl
3d_models/打印文件/STEP/ESP32-S3-LCD-1.47B_下盖.step
3d_models/盖板2.5mm_中壳加深_20261028/后盖_2.5mm_无围边_草图编辑.FCStd
3d_models/草图直接编辑工程/下盖_草图编辑.FCStd
3d_models/草图直接编辑工程_修正版/中间外壳_草图编辑.FCStd
3d_models/可编辑工程_参数化/上盖_参数化.FCStd
3d_models/打印文件/STEP/ESP32-S3-LCD-1.47B_中间件.step
3d_models/盖板2.5mm_中壳加深_20261028/打印文件/上盖_2.5mm_草图编辑.step
3d_models/草图直接编辑工程/中间外壳_草图编辑.FCStd
3d_models/草图直接编辑工程_修正版/下盖_草图编辑.FCStd
3d_models/盖板2.5mm_中壳加深_20261028/中间外壳_加深_草图编辑.FCStd
3d_models/ESP32-S3-LCD-1.47B_紧凑双层外壳_前盖.stl
3d_models/ESP32-S3-LCD-1.47B_紧凑双层外壳.FCStd
3d_models/ESP32-S3-LCD-1.47B.dwg
3d_models/后盖_传感器倒装_内缩1mm_20261028_预览/后盖_传感器倒装_薄膜内缩1mm_预览.FCStd
3d_models/后盖_传感器倒装_内缩1mm_20261028_预览/后盖_传感器倒装_薄膜内缩1mm_预览.stl
3d_models/后盖_传感器横置_20261028/后盖_传感器横置_20x18mm.FCStd
3d_models/后盖_传感器横置_20261028/后盖_传感器横置_20x18mm.stl
3d_models/盖板2.5mm_中壳加深_20261028/打印文件/上盖_2.5mm_草图编辑.stl
3d_models/盖板2.5mm_中壳加深_20261028/打印文件/中间外壳_加深_草图编辑.stl
3d_models/盖板2.5mm_中壳加深_20261028/打印文件/后盖_2.5mm_无围边_草图编辑.stl
3d_models/盖板2.5mm_中壳加深_20261028/打印文件/按键顶杆_突出1.5mm_打印2件.stl
