Tianyi-Lin/esp32_s3_scd41_co2_detector/3d_models/ESP32-S3-LCD-1.47B.pdf

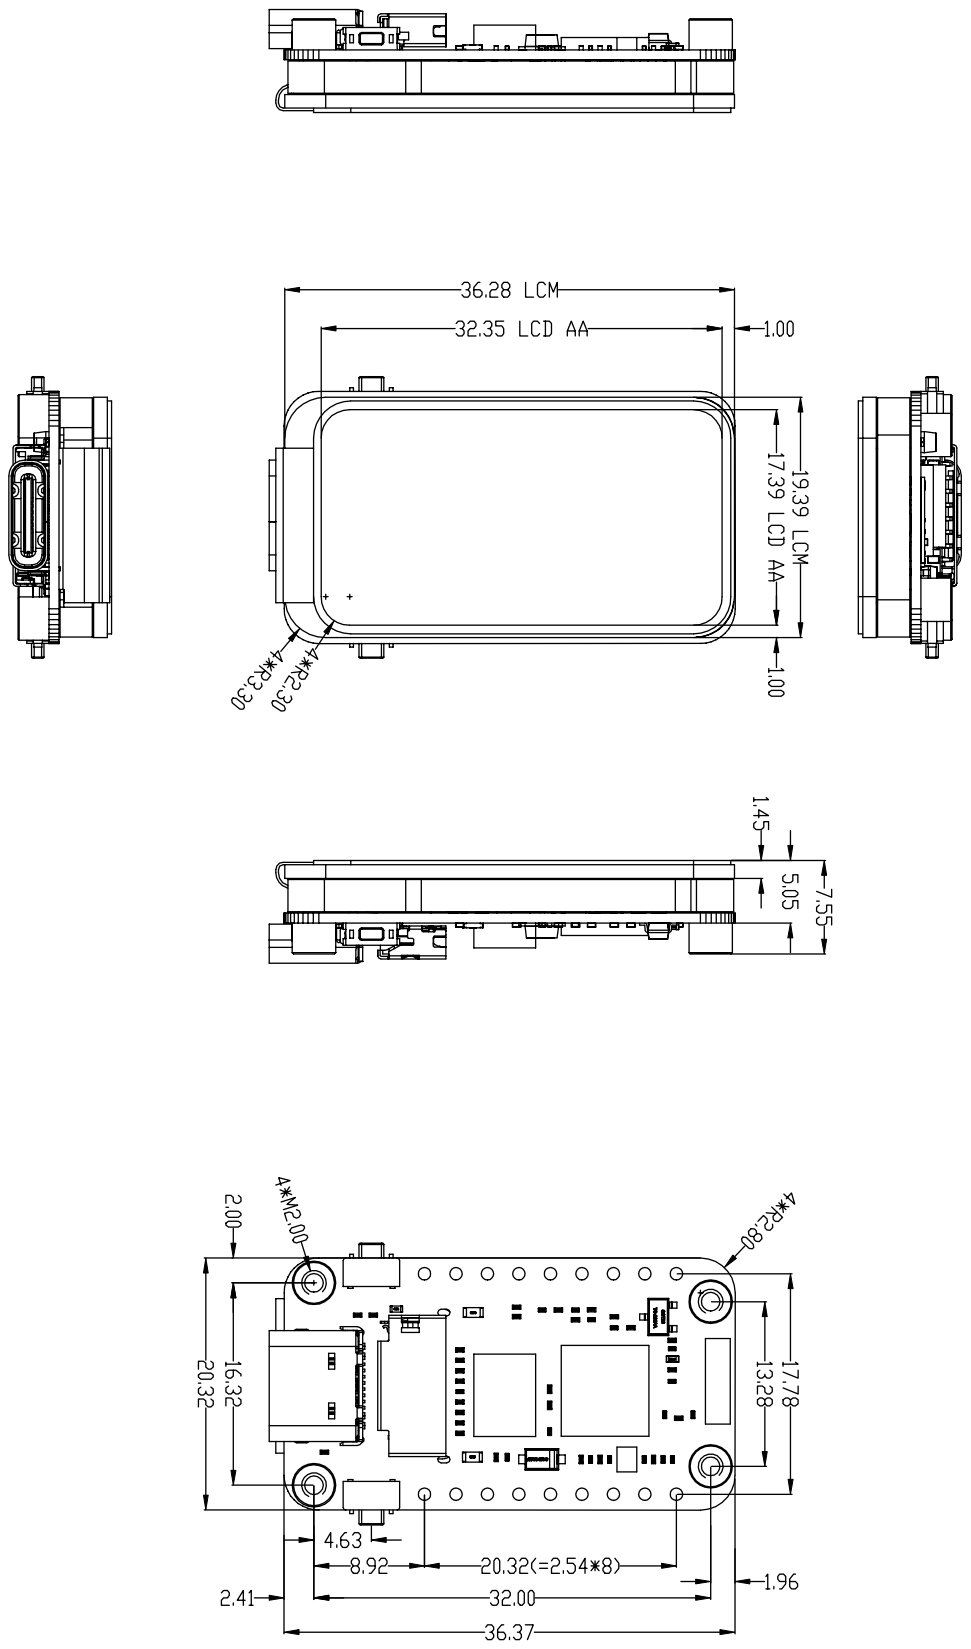
[picture p17: page 1]
