Tianyi-Lin/esp32_s3_scd41_co2_detector/(commit log)

2026-10-19 Initial ESP32-S3 SCD41 detector firmware
2026-10-28 Add 3D enclosure models and editable FreeCAD projects
2026-10-28 Sync LCD rotation fix and archive CAD generation scripts
2026-10-28 Unify cover plates at 2.5mm and move added depth to middle shell
2026-10-28 Make enclosure pieces semi-transparent in current assembly
2026-10-28 Correct CO2 connectors to left and right PCB ends
2026-10-28 Extend buttons to 1.5mm and raise side feet to 2mm
2026-10-28 Shift corner mounts and 45-degree flats outward by 0.3mm
2026-10-28 Fit rear window to actual sensor outline with 0.3mm side gap
2026-10-31 Move SCD41 to GPIO5/6 and support Arduino ESP32 3.x
